cspwcspw/ESP32_CamToLCD/(threads)

Thread 1 (2019-02-20):

DMABuffer.h：'malloc' was not declared in this scope

xsteamer, 2019-02-20:
hi~
I encountered this error，where could I found declaration of malloc？
DMABuffer.h：'malloc' was not declared in this scope
thx~~

xsteamer, 2019-02-20:
#include <stdlib.h>

Closed 2019-02-20.

Thread 2 (2019-05-19):

Wire.reset();

amirjak, 2019-05-19:
In file included from C:\Users\amir\AppData\Local\Temp\arduino_modified_sketch_876811\CamToLCD.ino:24:0:

sketch\CAM_OV7670.h: In constructor 'pw_OV7670::pw_OV7670(int, int, int, int, int, int, const int*, void (*)(DMABuffer*), void (*)())':

CAM_OV7670.h:292:12: error: 'class TwoWire' has no member named 'reset'

       Wire.reset();           // Without this, we cannot always get XCLK clock going.

            ^

sketch\CAM_OV7670.h: In member function 'void pw_OV7670::TestSuite(char*)':

CAM_OV7670.h:372:12: error: 'class TwoWire' has no member named 'reset'

       Wire.reset();

            ^

exit status 1
'class TwoWire' has no member named 'reset'

cspwcspw, 2019-05-19:
Yeah, looks like it has been removed from the new version of Wire library
because that functionality gets taken of elsewhere.

So perhaps just comment it out and see if indeed it is now redundant with
the later version of the Wire library.

https://github.com/espressif/arduino-esp32/issues/1679

Peter

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

amirjak, 2019-05-19:
Thanks😁

amirjak, 2019-05-19:
Awesome project😁

amirjak, 2019-05-19:
Awesome project

Closed 2020-05-13.

Thread 3 (2022-10-31):

Unable to recreate librarys outdated

Sentinel8000, 2022-10-31:
I try recreate this project with a different/current avaiable ov7670 camera, but first i have stuck wire library wont have reset command, also camera looks working without any impadance.

This project will be great, because with this camera we can get better FPS on a prallel TFT, but we cant attach a parallel TFT to a new esp32-cam board.

Currently this ov7670 l2s camera looks outdated, currently anybody using the esp32-cam, but esp32-cam less pins - unable to attach faster 8 bit parallel display.

This is the ov7670 what currently avaible localy, have only 8 data pin:

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

I have used these pins to connect camera with esp32 and i can get hpwever slow, but working picture:

<html>
<body>
<!--StartFragment-->

OV7670 pin | ESP32 pin

3.3V | 3.3V
GND | GND
SCL | D22
SDA | D21
VS | D34
HS | D35
PCLK | D33
MCLK | D32
D7 | D4
D6 | D12
D5 | D13
D4 | D14
D3 | D15
D2 | RX2
D1 | TX2
D0 | D27
RESET | -
PWDN | -

I have this type cheap NodeMCU board:

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

For parallel display i have used a larger 3.5" parallel ili9486, i have used these pins - i gived a try maybe the included minimal LCD library can handle. Used pins:

#define TFT_DC   9  //  (LCD_RS on my display)
#define TFT_CS   33
#define TFT_RST  10
#define TFT_RD   36
#define TFT_WR    2

#define TFT_D0   3
#define TFT_D1   1
#define TFT_D2   23
#define TFT_D3   26
#define TFT_D4   25
#define TFT_D5   19
#define TFT_D6   0
#define TFT_D7   18

I have not used any resistor, both display and camera worked standalone well.

After connected all pin, Esp32 looks have trouble handle everything from USBm so i can upload code, if im remove 5V/3.3V, i can upload code.

Because wire library currently wont have this manual reset function, i have commented out.

I need also add   timer_conf.clk_cfg = LEDC_USE_APB_CLK; line to CAM_OV7670.h after i can compile the code, but i still have trouble with VSYNC

After first start on Serial monitor i got random

VSYNC never went low;
VSYNC never went high

Messages, these also i have commented out, after i saw a estimated FPS, but after connect tft project unable to start.

I think there is lot problem: aged librarys, different / larger TFT, maybe bad used pins.

Maybe this code need full remake, but im sure after 4 years this is a impossible mission.
